anttikes/usb-fm-radio/Schematics/README.md

# The schematic

This folder contains the KiCad schematic and PCB layout file for the board.

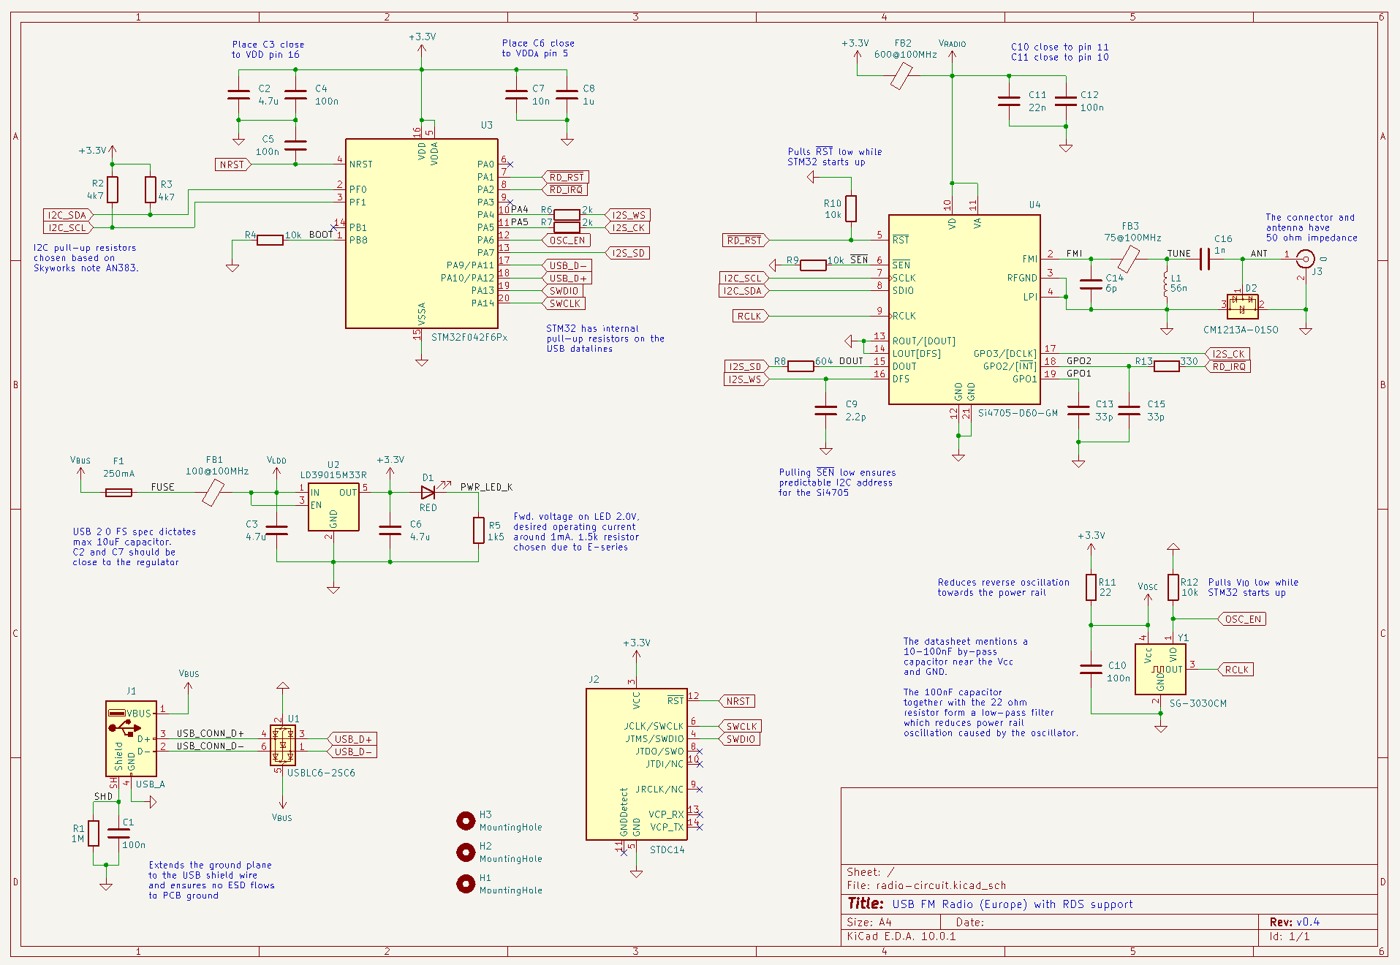
[picture p2: docs/Schematic.png]
Schematic


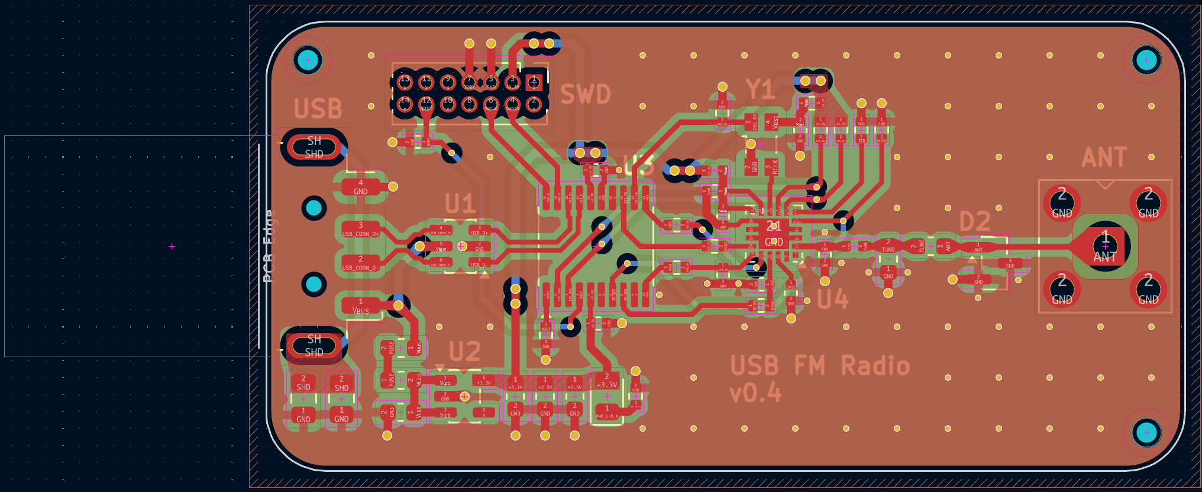
[picture p3: docs/PCBLayout.png]
PCB Layout


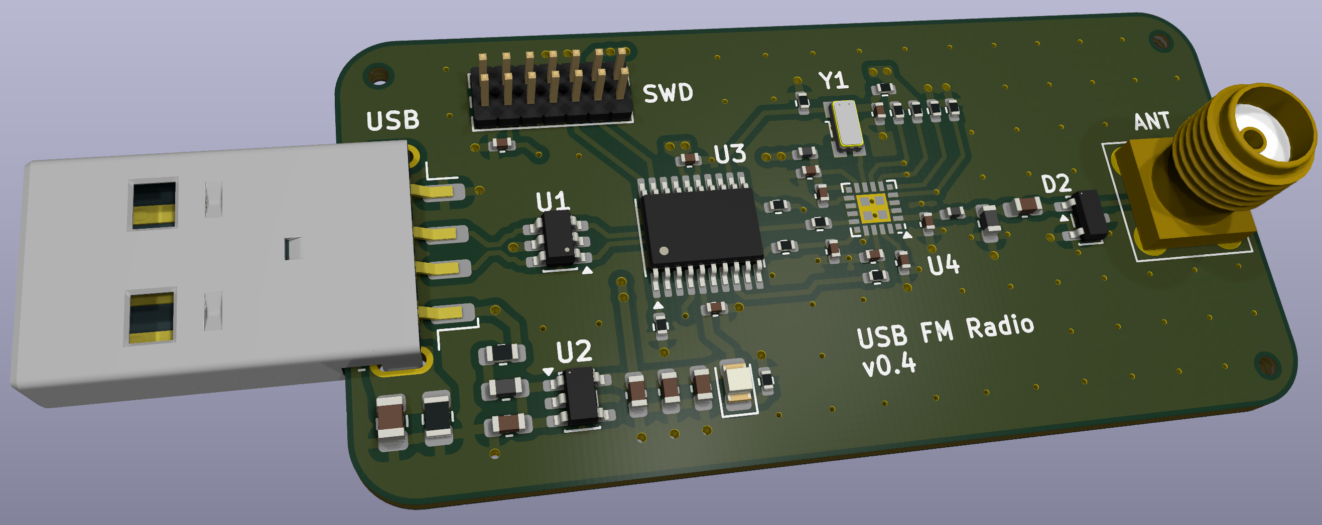
[picture p4: docs/3DModel.png]
3D Model


## Working on the project

To open this project download and install KiCad v10 for your operating system from [this page](https://www.kicad.org/download/).

## Generating the Bill of Materials

The KiCad project file contains a pre-made Bill of Materials definition preset that matches the format expected by JLCPCB. To generate a bill of materials for the project, open the schematic file, first choose "Tools" > "Generate Bill of Materials" and then switch to the "Edit" tab. From the preset selection in bottom-left choose "JLCPCB". Click "Apply, Save Schematic and Continue", and then "Export".

The Bill of Materials file (`radio-circuit.csv`) appears into the `output` folder.

## Generating Gerber, drill and component placement files

The KiCad project file contains the JLCPCB-compatible settings for Gerber and drill files. To generate them open the PCB Editor of the project, and:
 - Choose "File" > "Fabrciation Outputs" > "Gerbers" and "Plot" to generate the `.gbl` files to the `output` folder.
 - Choose "File" > "Fabrication Outputs" > "Drill Files" and "Generate" to generate the `.drl` files to the `output` folder.

Finally, choose "File" > "Fabrication Outputs" > "Component Placement", and click "Generate Position File" to generate the component placement file. The project uses top-side placement only so you can delete the `bottom-pos` file that appears.

### Modifying the component placement file

The file generated is not directly compatible with JLCPCB. You will have to edit the according to [these instructions](https://jlcpcb.com/help/article/How-to-generate-the-BOM-and-Centroid-file-from-KiCAD), from the "Generating Pick and Place files" onwards.
