anttikes/usb-fm-radio/GUI/resources/PowerButton.png

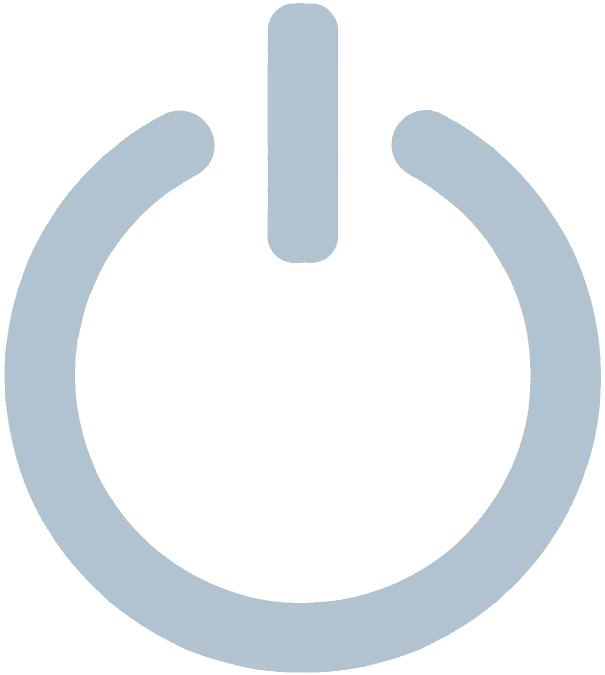
GUI/resources/PowerButton.png
