anttikes/usb-fm-radio/GUI/resources/StereoIndicator.png

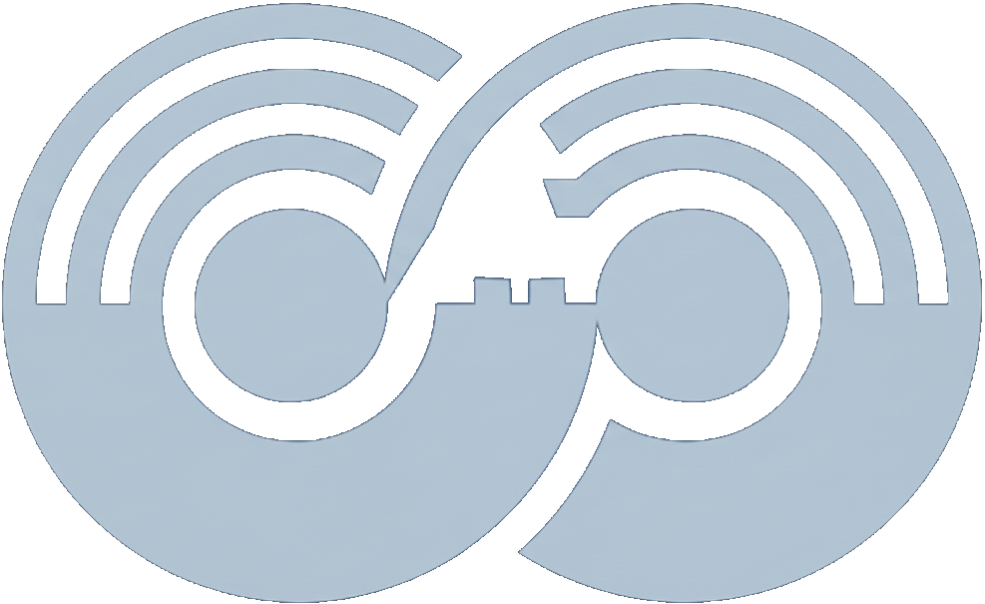
GUI/resources/StereoIndicator.png
