anttikes/usb-fm-radio/Schematics/radio-circuit.kicad_pcb

## KiCad design Schematics/radio-circuit.kicad_pcb (2026-09-28)

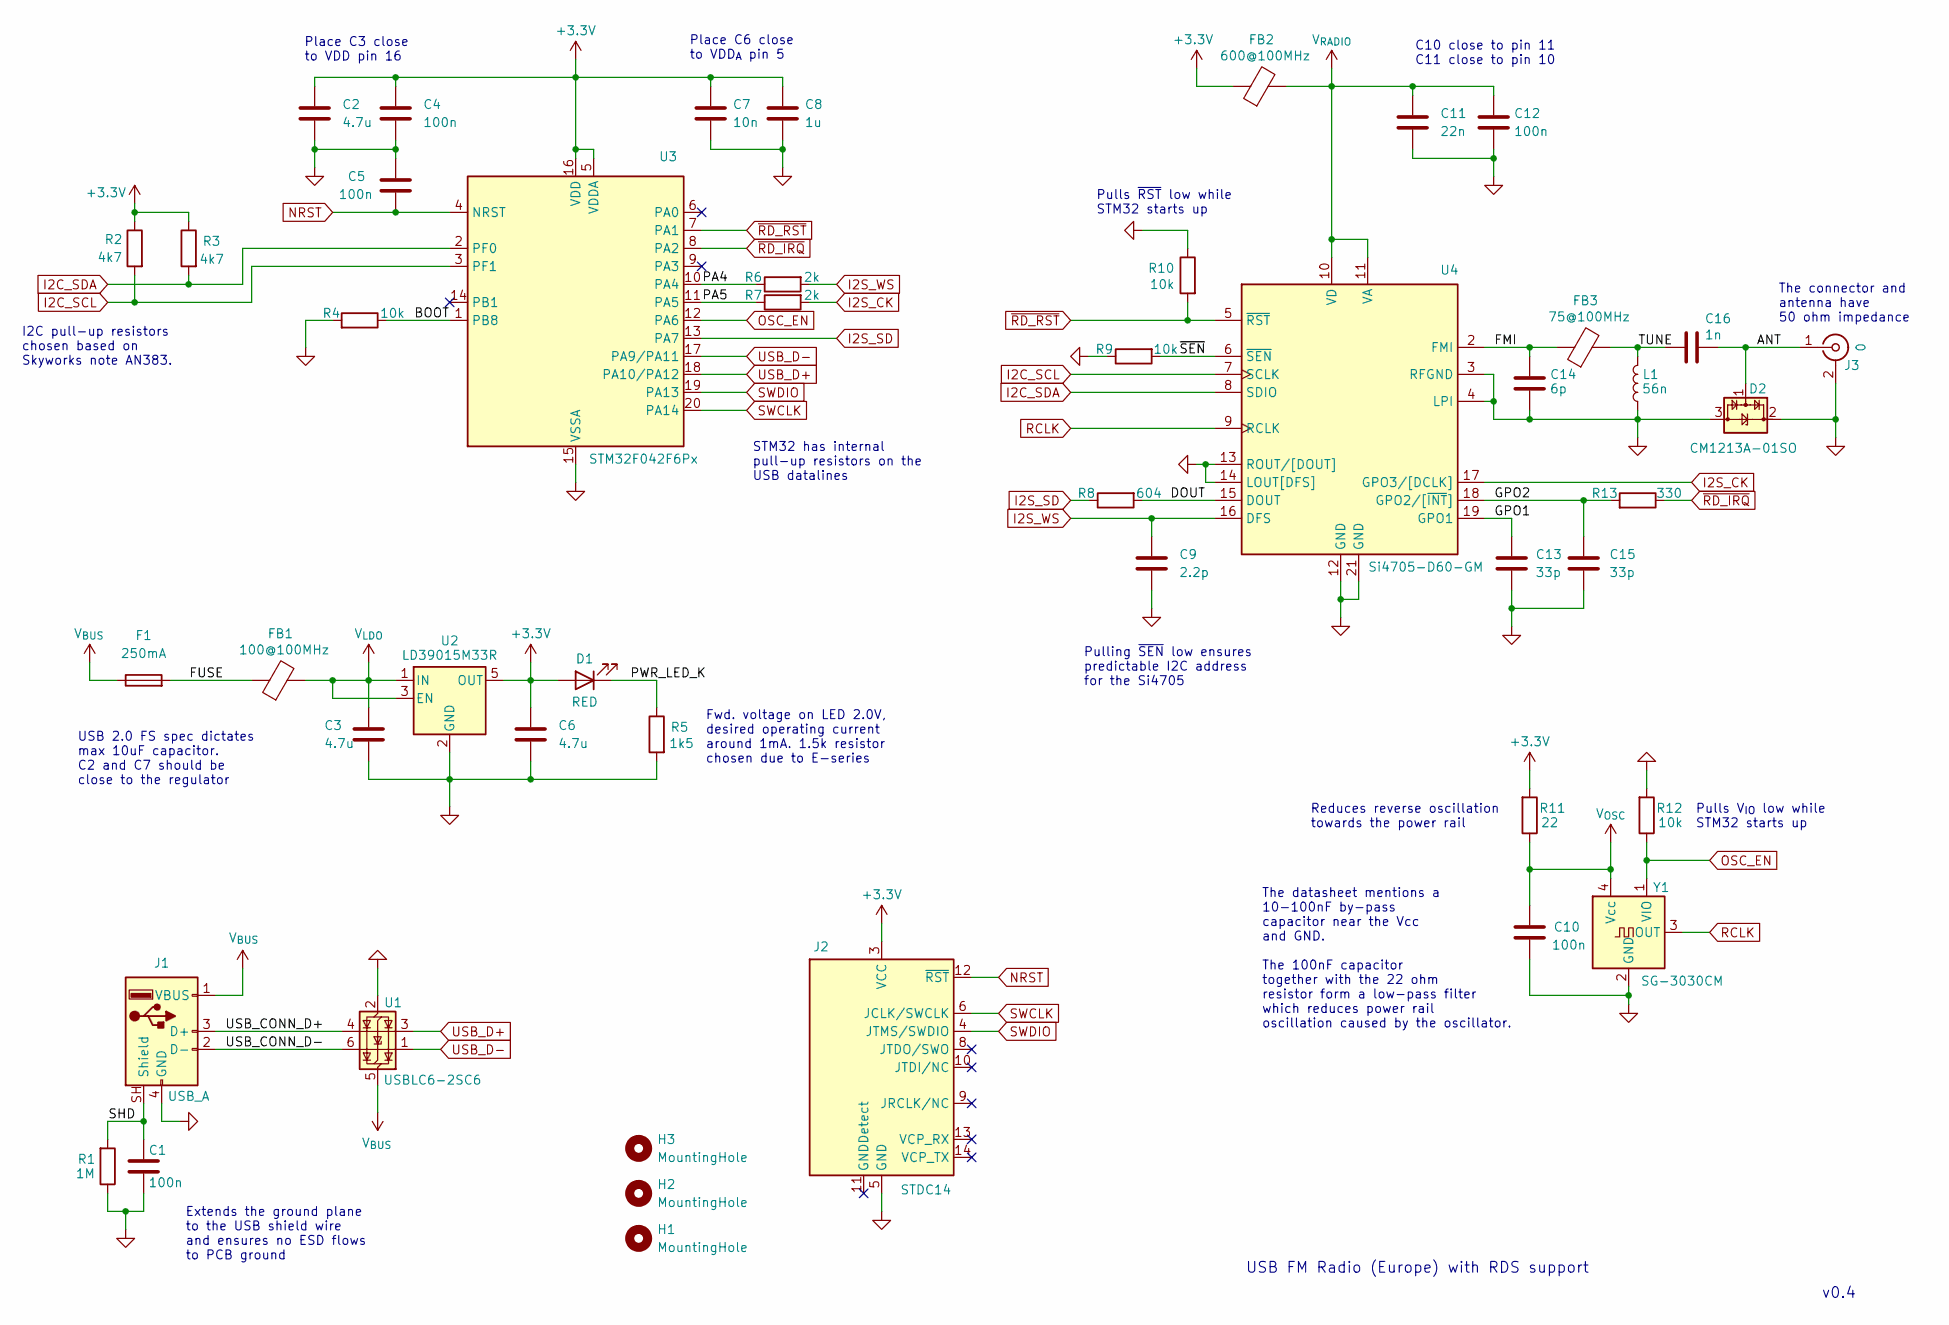
[picture p8: schematic radio-circuit.kicad_sch]

Parts:
C1: 100n; C_0805_2012Metric; JLCPCB Part Number C28233
C2, C3, C6: 4.7u; C_0603_1608Metric; JLCPCB Part Number C19666
C4, C5: 100n; C_0402_1005Metric; JLCPCB Part Number C1525
C7: 10n; C_0402_1005Metric; JLCPCB Part Number C15195
C8: 1u; C_0603_1608Metric; JLCPCB Part Number C15849
C9: 2.2p; C_0402_1005Metric; JLCPCB Part Number C1559
C10, C12: 100n; C_0402_1005Metric; JLCPCB Part Number C307331
C11: 22n; C_0402_1005Metric; JLCPCB Part Number C1532
C13, C15: 33p; C_0402_1005Metric; JLCPCB Part Number C1562
C14: 6p; C_0402_1005Metric; JLCPCB Part Number C30274
C16: 1n; C_0603_1608Metric; JLCPCB Part Number C1636
D1: RED; LED_0805_2012Metric; JLCPCB Part Number C84256
D2: CM1213A-01SO; SOT-23; JLCPCB Part Number C558429
F1: 250mA; Fuse_0603_1608Metric; JLCPCB Part Number C207012
FB1: 100@100MHz; L_0603_1608Metric; JLCPCB Part Number C14709
FB2: 600@100MHz; L_0402_1005Metric; JLCPCB Part Number C76886
FB3: 75@100MHz; L_0402_1005Metric; JLCPCB Part Number C113009
H1, H2, H3: MountingHole; MountingHole_JLCPCB
J1: USB_A; USB_A_AM180-01-T1-W; JLCPCB Part Number C19077262
J2: STDC14; PinHeader_2x07_P1.27mm_Vertical; JLCPCB Part Number C2935955
J3: 0; SMA_BAT_Wireless_BWSMA-KE-Z001; JLCPCB Part Number C496549
L1: 56n; L_0603_1608Metric; JLCPCB Part Number C98080
R1: 1M; R_0805_2012Metric; JLCPCB Part Number C17514
R2, R3: 4k7; R_0402_1005Metric; JLCPCB Part Number C25900
R4, R9, R10, R12: 10k; R_0402_1005Metric; JLCPCB Part Number C25744
R5: 1k5; R_0402_1005Metric; JLCPCB Part Number C25867
R6, R7: 2k; R_0402_1005Metric; JLCPCB Part Number C4109
R8: 604; R_0402_1005Metric; JLCPCB Part Number C8369
R11: 22; R_0402_1005Metric; JLCPCB Part Number C25092
R13: 330; R_0402_1005Metric; JLCPCB Part Number C25104
U1: USBLC6-2SC6; SOT-23-6; JLCPCB Part Number C7519
U2: LD39015M33R; SOT-23-5; JLCPCB Part Number C2798212
U3: STM32F042F6Px; TSSOP-20_4.4x6.5mm_P0.65mm; JLCPCB Part Number C81000
U4: Si4705-D60-GM; Skyworks_QFN-20-1EP_3x3mm_P0.5mm_EP1.8x1.8mm; JLCPCB Part Number C1526114
Y1: SG-3030CM; Oscillator_SMD_SeikoEpson_SG3030CM; JLCPCB Part Number C256005

Connections:
+3.3V: C2.1, C4.1, C6.1, C7.1, C8.1, D1.2 (A), FB2.1, J2.3 (VCC), R2.1, R3.1, R11.2, U2.5 (OUT), U3.5 (VDDA), U3.16 (VDD)
/ ~SEN: R9.2, U4.6 (~SEN)
/ANT: C16.1, D2.1 (CH1), J3.1 (In)
/BOOT: R4.1, U3.1 (PB8)
/DOUT: R8.2, U4.15 (DOUT)
/FMI: C14.1, FB3.1, U4.2 (FMI)
/FUSE: F1.2, FB1.1
/GPO1: C13.1, U4.19 (GPO1)
/GPO2: C15.1, R13.2, U4.18 (GPO2/[~INT])
/PA4: R6.1, U3.10 (PA4)
/PA5: R7.1, U3.11 (PA5)
/PWR_LED_K: D1.1 (K), R5.1
/SHD: C1.2, J1.SH (Shield), R1.2
/TUNE: C16.2, FB3.2, L1.2
/USB_CONN_D+: J1.3 (D+), U1.4 (I/O2)
/USB_CONN_D-: J1.2 (D-), U1.6 (I/O1)
GND: C1.1, C2.2, C3.2, C4.2, C5.2, C6.2, C7.2, C8.2, C9.2, C10.2, C11.2, C12.2, C13.2, C14.2, C15.2, D2.2 (VP), D2.3 (VN), J1.4 (GND), J2.5 (GND), J2.7 (GND), J3.2 (Ext), L1.1, R1.1, R4.2, R5.2, R9.1, R10.1, R12.2, U1.2 (GND), U2.2 (GND), U3.15 (VSSA), U4.3 (RFGND), U4.4 (LPI), U4.12 (GND), U4.13 (ROUT/[DOUT]), U4.14 (LOUT[DFS]), U4.21 (GND), Y1.2 (GND)
I2C_SCL: R2.2, U3.3 (PF1), U4.7 (SCLK)
I2C_SDA: R3.2, U3.2 (PF0), U4.8 (SDIO)
I2S_CK: R7.2, U4.17 (GPO3/[DCLK])
I2S_SD: R8.1, U3.13 (PA7)
I2S_WS: C9.1, R6.2, U4.16 (DFS)
NRST: C5.1, J2.12 (~RST), U3.4 (NRST)
OSC_EN: R12.1, U3.12 (PA6), Y1.1 (VIO)
RCLK: U4.9 (RCLK), Y1.3 (OUT)
SWCLK: J2.6 (JCLK/SWCLK), U3.20 (PA14)
SWDIO: J2.4 (JTMS/SWDIO), U3.19 (PA13)
USB_D+: U1.3 (I/O2), U3.18 (PA10/PA12)
USB_D-: U1.1 (I/O1), U3.17 (PA9/PA11)
V_{BUS}: F1.1, J1.1 (VBUS), U1.5 (VBUS)
V_{LDO}: C3.1, FB1.2, U2.1 (IN), U2.3 (EN)
V_{OSC}: C10.1, R11.1, Y1.4 (Vcc)
V_{RADIO}: C11.1, C12.1, FB2.2, U4.10 (VD), U4.11 (VA)
~RD_IRQ: R13.1, U3.8 (PA2)
~RD_RST: R10.2, U3.7 (PA1), U4.5 (~RST)

Notes on the sheet:
Pulls ~{RST} low while STM32 starts up
Place C6 close to VDD_{A} pin 5
USB FM Radio (Europe) with RDS support
STM32 has internal pull-up resistors on the USB datalines
I2C pull-up resistors chosen based on Skyworks note AN383.
USB 2.0 FS spec dictates max 10uF capacitor. C2 and C7 should be close to the regulator
The connector and antenna have 50 ohm impedance
Extends the ground plane to the USB shield wire and ensures no ESD flows to PCB ground
C10 close to pin 11 C11 close to pin 10
Pulls V_{IO} low while STM32 starts up
Reduces reverse oscillation towards the power rail
v0.4
Pulling ~{SEN} low ensures predictable I2C address for the Si4705
Fwd. voltage on LED 2.0V, desired operating current around 1mA. 1.5k resistor chosen due to E-series
The datasheet mentions a 10-100nF by-pass capacitor near the Vcc and GND. The 100nF capacitor together with the 22 ohm resistor form a low-pass filter which reduces power rail oscillation caused by the oscillator.
Place C3 close to VDD pin 16

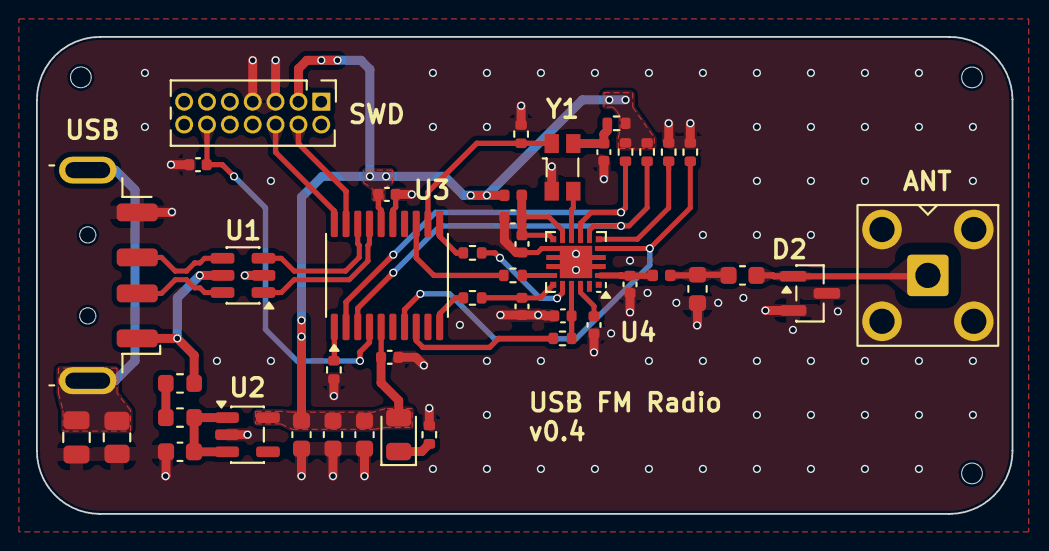
[picture p9: board radio-circuit.kicad_pcb from above]

Board: 4 copper layers, 54.2 x 26.5 mm, 47 parts (0 on the bottom side), 35 nets.
