anttikes/usb-fm-radio/Firmware/Core/main.c

/**
 ******************************************************************************
 * @file    main.c
 * @brief   Main program body
 ******************************************************************************
 * @attention
 *
 * Copyright (c) Antti Keskinen
 * All rights reserved.
 *
 * This software is licensed under terms that can be found in the LICENSE file
 * in the root directory of this software component.
 *
 ******************************************************************************
 */

/* Includes ------------------------------------------------------------------*/
#include "main.h"
#include "commands.h"
#include "common.h"
#include "device.h"
#include "dma.h"
#include "gpio.h"
#include "i2c.h"
#include "i2s.h"
#include "properties.h"
#include "rds.h"
#include "tim.h"
#include "tusb.h"

/* Global variables ----------------------------------------------------------*/

/* Private types -------------------------------------------------------------*/

/* Private constants ---------------------------------------------------------*/

// Size of the staging buffer has an effect on the CPU usage; smaller buffer means
// more interrupts and thus more transfers into the TinyUSB FIFO
// With 2 ms FIFO length, a ratio of 1:4 or smaller causes the
// DMA transfer to occasionally overflow the FIFO buffer
#define DMA_BUFFER_LENGTH CFG_TUD_AUDIO_FUNC_1_EP_IN_SW_BUF_SZ / 8
#define DMA_BUFFER_START 0
#define DMA_BUFFER_MIDPOINT DMA_BUFFER_LENGTH / 2

/* Private macros ------------------------------------------------------------*/

/* Private variables ---------------------------------------------------------*/
uint8_t i2sBuffer[DMA_BUFFER_LENGTH];

/* Private function prototypes -----------------------------------------------*/

/* Exported functions --------------------------------------------------------*/

/**
 * @brief  The application entry point.
 * @retval None
 */
int main(void)
{
    // Initialize HAL
    HAL_Init();

    // Configure the system clock
    SystemClock_Config();

    // Initialize peripherals
    MX_GPIO_Init();
    MX_DMA_Init();
    MX_I2C1_Init();
    MX_I2S1_Init();
    MX_TIM16_Init();
    MX_TIM17_Init();

    // Initialize the RDS parser library
    RDSInit();

    // Bring Si4705 out of reset, and enable the oscillator
    HAL_GPIO_WritePin(RD_RST_GPIO_Port, RD_RST_Pin, GPIO_PIN_SET);
    HAL_GPIO_WritePin(OSC_EN_GPIO_Port, OSC_EN_Pin, GPIO_PIN_SET);

    // The oscillator has a max startup time of one second
    // The radio chip also has a startup time but it is much faster than the
    // crystal
    HAL_Delay(1250);

    // Start the timer that's used to report device status
    HAL_TIM_Base_Start_IT(&htim17);

    // Power up the radio
    if (!PowerUp(&radioDevice,
                 POWER_UP_ARGS_1_FUNCTION_FM | POWER_UP_ARGS_1_GPO2_OUTPUT_ENABLE |
                     POWER_UP_ARGS_1_CTS_INTERRUPT_ENABLE,
                 POWER_UP_ARGS_2_DIGITAL_OUTPUT_2))
    {
        Error_Handler();
    }

    // Enable other interrupt sources
    if (!SetInterruptSources(&radioDevice,
                             GPO_IEN_ARGS_CTSIEN | GPO_IEN_ARGS_STCIEN | GPO_IEN_ARGS_RDSIEN | GPO_IEN_ARGS_ERRIEN))
    {
        Error_Handler();
    }

    // Initialize volume from the radio state
    if (!SetVolume(&radioDevice, radioDevice.currentVolume))
    {
        Error_Handler();
    }

    // Allow GPO output, and drive GPO1 and GPO3 low to reduce oscillation
    if (!GPIOCtl(&radioDevice, GPIO_CTL_GPO1_OUTPUT_ENABLE | GPIO_CTL_GPO3_OUTPUT_ENABLE))
    {
        Error_Handler();
    }

    if (!GPIOSet(&radioDevice, GPIO_SET_GPO2_OUTPUT_HIGH))
    {
        Error_Handler();
    }

    // Set FM de-emphasis to match Europe
    if (!SetFMDeemphasis(&radioDevice, FM_DEEMPHASIS_ARGS_50_MICROSECONDS))
    {
        Error_Handler();
    }

    // Configure RDS to raise interrupt when buffers are full
    if (!SetRDSInterruptSources(&radioDevice, FM_RDS_INT_SOURCE_ARGS_RDSRECV))
    {
        Error_Handler();
    }

    // Enable RDS processing, and allow max number of errors
    if (!SetRDSConfig(&radioDevice, FM_RDS_CONFIG_ARGS_BLETHA_ERROR_MAX_5_BITS |
                                        FM_RDS_CONFIG_ARGS_BLETHB_ERROR_MAX_5_BITS |
                                        FM_RDS_CONFIG_ARGS_BLETHC_ERROR_MAX_5_BITS |
                                        FM_RDS_CONFIG_ARGS_BLETHD_ERROR_MAX_5_BITS | FM_RDS_CONFIG_ARGS_RDS_ENABLE))
    {
        Error_Handler();
    }

    // Tune to Kasari
    if (!TuneFreq(&radioDevice, FM_TUNE_FREQ_ARGS_NONE, 9410))
    {
        Error_Handler();
    }

    // Start receiving I2S data through DMA; this provides DCLK and DFS
    // for the radio chip. When using circular mode, the size parameter
    // must equal the number of audio samples we want to read during one cycle
    if (HAL_I2S_Receive_DMA(&hi2s1, (uint16_t *)&i2sBuffer[0], DMA_BUFFER_LENGTH / 2) != HAL_OK)
    {
        Error_Handler();
    }

    // USB needs only peripheral clock and interrupt priority; TinyUSB takes care of the rest
    __HAL_RCC_USB_CLK_ENABLE();
    HAL_NVIC_SetPriority(USB_IRQn, 0, 0);

    // Initialize TinyUSB
    tusb_rhport_init_t dev_init = {.role = TUSB_ROLE_DEVICE, .speed = TUSB_SPEED_FULL};

    tusb_init(BOARD_DEVICE_RHPORT_NUM, &dev_init);

    /* Infinite loop */
    while (1)
    {
        tud_task();

        if (!ProcessCommand(&radioDevice))
        {
            if (radioDevice.interruptCounter > 0)
            {
                radioDevice.interruptCounter--;

                // There was no command to process but an interrupt is pending
                // This usually indicates e.g. RDS or RSQ interrupt
                // so schedule the GetIntStatus command
                GetIntStatus(&radioDevice);
            }
        }

        ProcessReport(&radioDevice);
    }
}

/**
 * @brief System Clock Configuration
 * @retval None
 */
void SystemClock_Config(void)
{
    RCC_OscInitTypeDef RCC_OscInitStruct = {0};
    RCC_ClkInitTypeDef RCC_ClkInitStruct = {0};
    RCC_PeriphCLKInitTypeDef PeriphClkInit = {0};
    RCC_CRSInitTypeDef RCC_CRSInitStruct = {0};

    /* Initialize the RCC Oscillators */
    RCC_OscInitStruct.OscillatorType = RCC_OSCILLATORTYPE_HSI48;
    RCC_OscInitStruct.HSI48State = RCC_HSI48_ON;
    RCC_OscInitStruct.PLL.PLLState = RCC_PLL_ON;
    RCC_OscInitStruct.PLL.PLLSource = RCC_PLLSOURCE_HSI48;
    RCC_OscInitStruct.PLL.PLLMUL = RCC_PLL_MUL4;
    RCC_OscInitStruct.PLL.PREDIV = RCC_PREDIV_DIV5;

    if (HAL_RCC_OscConfig(&RCC_OscInitStruct) != HAL_OK)
    {
        Error_Handler();
    }

    /* Initialize the CPU, AHB and APB buses clocks */
    RCC_ClkInitStruct.ClockType = RCC_CLOCKTYPE_HCLK | RCC_CLOCKTYPE_SYSCLK | RCC_CLOCKTYPE_PCLK1;
    RCC_ClkInitStruct.SYSCLKSource = RCC_SYSCLKSOURCE_PLLCLK;
    RCC_ClkInitStruct.AHBCLKDivider = RCC_SYSCLK_DIV1;
    RCC_ClkInitStruct.APB1CLKDivider = RCC_HCLK_DIV1;

    if (HAL_RCC_ClockConfig(&RCC_ClkInitStruct, FLASH_LATENCY_1) != HAL_OK)
    {
        Error_Handler();
    }

    PeriphClkInit.PeriphClockSelection = RCC_PERIPHCLK_USB | RCC_PERIPHCLK_I2C1;
    PeriphClkInit.I2c1ClockSelection = RCC_I2C1CLKSOURCE_SYSCLK;
    PeriphClkInit.UsbClockSelection = RCC_USBCLKSOURCE_HSI48;

    if (HAL_RCCEx_PeriphCLKConfig(&PeriphClkInit) != HAL_OK)
    {
        Error_Handler();
    }

    /* Enable the CRS clock */
    __HAL_RCC_CRS_CLK_ENABLE();

    /* Configure CRS */
    RCC_CRSInitStruct.Prescaler = RCC_CRS_SYNC_DIV1;
    RCC_CRSInitStruct.Source = RCC_CRS_SYNC_SOURCE_USB;
    RCC_CRSInitStruct.Polarity = RCC_CRS_SYNC_POLARITY_RISING;
    RCC_CRSInitStruct.ReloadValue = __HAL_RCC_CRS_RELOADVALUE_CALCULATE(48000000, 1000);
    RCC_CRSInitStruct.ErrorLimitValue = 34;
    RCC_CRSInitStruct.HSI48CalibrationValue = 32;

    HAL_RCCEx_CRSConfig(&RCC_CRSInitStruct);
}

/**
 * @brief  This function is executed in case of error occurrence.
 * @retval None
 */
void Error_Handler(void)
{
    /* User can add his own implementation to report the HAL error return state */
    __disable_irq();
    while (1)
    {
    }
}

/* External callbacks --------------------------------------------------------*/

/**
 * @brief  Rx Transfer half completed callbacks
 * @param  hi2s pointer to a I2S_HandleTypeDef structure that contains
 *         the configuration information for I2S module
 * @retval None
 */
void HAL_I2S_RxHalfCpltCallback(I2S_HandleTypeDef *hi2s)
{
    if (hi2s->Instance == SPI1)
    {
        tud_audio_write(&i2sBuffer[DMA_BUFFER_START], DMA_BUFFER_LENGTH / 2);
    }
}

/**
 * @brief  Rx Transfer completed callbacks
 * @param  hi2s pointer to a I2S_HandleTypeDef structure that contains
 *         the configuration information for I2S module
 * @retval None
 */
void HAL_I2S_RxCpltCallback(I2S_HandleTypeDef *hi2s)
{
    if (hi2s->Instance == SPI1)
    {
        tud_audio_write(&i2sBuffer[DMA_BUFFER_MIDPOINT], DMA_BUFFER_LENGTH / 2);
    }
}

/* Private functions ---------------------------------------------------------*/

#ifdef USE_FULL_ASSERT
/**
 * @brief  Reports the name of the source file and the source line number
 *         where the assert_param error has occurred.
 * @param  file: pointer to the source file name
 * @param  line: assert_param error line source number
 * @retval None
 */
void assert_failed(uint8_t *file, uint32_t line)
{
    UNUSED(file);
    UNUSED(line);

    /* User can add his own implementation to report the file name and line
       number, ex: printf("Wrong parameters value: file %s on line %d\r\n", file,
       line) */
}
#endif /* USE_FULL_ASSERT */
