anttikes/usb-fm-radio/Firmware/Firmware.ioc

Mcu.UserName=STM32F042C6Tx
PA11.Signal=USB_DM
PA12.Signal=USB_DP
PA13.Signal=SYS_SWDIO
PA14.Signal=SYS_SWCLK
PA4.Signal=I2S1_WS
PA5.Signal=I2S1_CK
PA7.Signal=I2S1_SD
PC13.GPIO_Label=RADIO_NIRQ
PC13.Signal=GPXTI13
PC14OSC32_IN.GPIO_Label=RADIO_NRST
PC14OSC32_IN.Signal=GPIO_Output
PC15OSC32_OUT.GPIO_Label=RCLK_EN
PC15OSC32_OUT.Signal=GPIO_Output
PF0-OSC_IN.Signal=I2C1_SDA
PF1-OSC_OUT.Signal=I2C1_SCL
