anttikes/usb-fm-radio/Firmware/Radio/device.c

/**
 ******************************************************************************
 * @file    device.h
 * @brief   Implements functions to manage radio device state and
 *          command processing.
 ******************************************************************************
 * @attention
 *
 * Copyright (c) Antti Keskinen
 * All rights reserved.
 *
 * This software is licensed under terms that can be found in the LICENSE file
 * in the root directory of this software component.
 *
 ******************************************************************************
 */

/* Includes ------------------------------------------------------------------*/
#include "device.h"
#include "commands.h"
#include "common.h"
#include "i2c.h"
#include "main.h"
#include "rds.h"
#include "stm32f0xx_hal.h"
#include "tim.h"
#include "tusb.h"

/* Global variables ----------------------------------------------------------*/

// clang-format off
RadioDevice_t radioDevice = {
    .deviceAddress = SI4705_I2C_ADDRESS,
    .currentState = RADIOSTATE_POWERDOWN,
    .currentFrequency = 0,
    .currentVolume = SI4705_VOLUME_MAX_SETTING / 2,
    .interruptCounter = 0,
    .isMuted = false,
    .commandQueue = {
        .commands = {{0}},
        .count = 0,
        .front = 0,
        .back = 0
    },
    .reportQueue = {
        .reports = {{0}},
        .count = 0,
        .front = 0,
        .back = 0
    }
};
// clang-format on

/* Private types -------------------------------------------------------------*/

/* Private constants ---------------------------------------------------------*/

/* Private macros ------------------------------------------------------------*/

/* Private variables ---------------------------------------------------------*/
volatile bool i2cTransferInterruptRaised = false;
volatile bool i2cReceiveInterruptRaised = false;

/* Private function prototypes -----------------------------------------------*/
static Command_t *PeekCommand(CommandQueue_t *queue);
static Command_t *PopCommand(CommandQueue_t *queue);
static Report_t *PopReport(ReportQueue_t *queue);

/* Exported functions --------------------------------------------------------*/

/**
 * @brief  Processes the commands in the queue, if there are any
 * @param  device Pointer to the radio device structure
 *
 * @retval True if a command was somehow processed; false otherwise
 */
bool ProcessCommand(RadioDevice_t *device)
{
    volatile Command_t *currentCommand = PeekCommand(&device->commandQueue);

    if (currentCommand == NULL)
    {
        return false;
    }

    if (currentCommand->state == COMMANDSTATE_IDLE)
    {
        currentCommand->state = COMMANDSTATE_SENDING;

        HAL_StatusTypeDef status = HAL_I2C_Master_Transmit_IT(
            &hi2c1, device->deviceAddress, (uint8_t *)&currentCommand->args, currentCommand->argLength);

        if (status != HAL_OK)
        {
            Error_Handler();
        }

        return true;
    }
    else if (currentCommand->state == COMMANDSTATE_SENDING && i2cTransferInterruptRaised)
    {
        i2cTransferInterruptRaised = false;

        if (currentCommand->args.opCode == CMD_ID_FM_TUNE_FREQ || currentCommand->args.opCode == CMD_ID_FM_SEEK_START)
        {
            radioDevice.currentState = RADIOSTATE_TUNE_IN_PROGRESS;

            currentCommand->state = COMMANDSTATE_WAITING_FOR_STC;
        }
        else
        {
            currentCommand->state = COMMANDSTATE_WAITING_FOR_CTS;
        }

        return true;
    }
    else if (currentCommand->state == COMMANDSTATE_WAITING_FOR_STC && radioDevice.interruptCounter > 0)
    {
        radioDevice.interruptCounter--;

        currentCommand->state = COMMANDSTATE_WAITING_FOR_CTS;

        return true;
    }
    else if (currentCommand->state == COMMANDSTATE_WAITING_FOR_CTS && radioDevice.interruptCounter > 0)
    {
        radioDevice.interruptCounter--;

        if (currentCommand->responseLength > 0)
        {
            currentCommand->state = COMMANDSTATE_WAITING_FOR_RESPONSE_RETRIEVAL;
        }
        else
        {
            currentCommand->state = COMMANDSTATE_READY;
        }

        return true;
    }
    else if (currentCommand->state == COMMANDSTATE_WAITING_FOR_RESPONSE_RETRIEVAL)
    {
        currentCommand->state = COMMANDSTATE_RECEIVING_RESPONSE;

        HAL_StatusTypeDef status = HAL_I2C_Master_Receive_IT(
            &hi2c1, device->deviceAddress, (uint8_t *)&currentCommand->response, currentCommand->responseLength);

        if (status != HAL_OK)
        {
            Error_Handler();
        }

        return true;
    }
    else if (currentCommand->state == COMMANDSTATE_RECEIVING_RESPONSE && i2cReceiveInterruptRaised)
    {
        i2cReceiveInterruptRaised = false;

        currentCommand->state = COMMANDSTATE_RESPONSE_RECEIVED;

        return true;
    }
    else if (currentCommand->state == COMMANDSTATE_RESPONSE_RECEIVED)
    {
        switch (currentCommand->args.opCode)
        {
        case CMD_ID_GET_PROPERTY:
            ProcessGetProperty(device, (Command_t *)currentCommand);
            break;

        case CMD_ID_FM_RSQ_STATUS:
            ProcessRSQStatus(device, (Command_t *)currentCommand);
            break;

        default:
            break;
        }

        currentCommand->state = COMMANDSTATE_READY;
    }
    else if (currentCommand->state == COMMANDSTATE_READY)
    {
        if (currentCommand->args.opCode == CMD_ID_POWER_UP && currentCommand->responseLength == 0)
        {
            device->currentState = RADIOSTATE_POWERUP;
        }
        else if (currentCommand->args.opCode == CMD_ID_POWER_DOWN)
        {
            device->currentState = RADIOSTATE_POWERDOWN;

            HAL_TIM_Base_Stop(&htim16);
        }
        else if (currentCommand->args.opCode == CMD_ID_FM_TUNE_FREQ ||
                 currentCommand->args.opCode == CMD_ID_FM_SEEK_START)
        {
            device->currentState = RADIOSTATE_TUNED_TO_STATION;

            HAL_TIM_Base_Start_IT(&htim16);

            // After tuning or seek has completed, set the sample rate so the chip begins sending audio samples
            SetProperty(&radioDevice, PROP_ID_DIGITAL_OUTPUT_SAMPLE_RATE, CFG_TUD_AUDIO_FUNC_1_SAMPLE_RATE);

            // Schedule a GetTuneStatus to update the current frequency reading and clear the STCINT bit
            TuneStatus(device, GET_TUNE_STATUS_ARGS_INTACK);

            // Reset the RDS parser state
            RDSReset();
        }
        else if (currentCommand->args.opCode == CMD_ID_FM_TUNE_STATUS)
        {
            device->currentFrequency =
                (uint16_t)((currentCommand->response[2] << 8) | (currentCommand->response[3] << 0));
        }
        else if (currentCommand->args.opCode == CMD_ID_GET_INT_STATUS)
        {
            // bool clearToSend = currentCommand->response[0] & 0x80;
            // bool error = currentCommand->response[0] & 0x40;
            // bool rsqInterrupt = currentCommand->response[0] & 0x08;
            bool rdsInterrupt = currentCommand->response[0] & 0x04;
            // bool seekTuneCompleted = currentCommand->response[0] & 0x01;

            if (rdsInterrupt)
            {
                RDSStatus(device, FM_RDS_STATUS_ARGS_INTACK);
            }
        }
        else if (currentCommand->args.opCode == CMD_ID_SET_PROPERTY)
        {
            PropertyIdentifiers_t property =
                (PropertyIdentifiers_t)((currentCommand->args.bytes[2] << 8) | (currentCommand->args.bytes[3] << 0));

            uint16_t value = (uint16_t)((currentCommand->args.bytes[4] << 8) | (currentCommand->args.bytes[5] << 0));

            if (property == PROP_ID_DIGITAL_OUTPUT_SAMPLE_RATE)
            {
                if (value != 0)
                {
                    device->currentState = RADIOSTATE_DIGITAL_OUTPUT_ENABLED;
                }
                else
                {
                    device->currentState = RADIOSTATE_TUNED_TO_STATION;
                }
            }
            else if (property == PROP_ID_RX_VOLUME)
            {
                device->currentVolume = value;
            }
            else if (property == PROP_ID_RX_HARD_MUTE)
            {
                if (value == 0)
                {
                    device->isMuted = false;
                }
                else if (value & 0b11)
                {
                    device->isMuted = true;
                }

                // Per-channel mute status is not supported
            }

            // Tuner programming guide outlines that a property
            // set operation always completes in 10 ms
            HAL_Delay(10);
        }
        else if (currentCommand->args.opCode == CMD_ID_FM_RDS_STATUS)
        {
            uint8_t fifoCount = currentCommand->response[3];

            uint16_t blockA = (uint16_t)((currentCommand->response[4] << 8) | (currentCommand->response[5] << 0));
            uint16_t blockB = (uint16_t)((currentCommand->response[6] << 8) | (currentCommand->response[7] << 0));
            uint16_t blockC = (uint16_t)((currentCommand->response[8] << 8) | (currentCommand->response[9] << 0));
            uint16_t blockD = (uint16_t)((currentCommand->response[10] << 8) | (currentCommand->response[11] << 0));

            uint8_t blockAErrors = currentCommand->response[12] & 0xC0;
            uint8_t blockBErrors = currentCommand->response[12] & 0x30;
            uint8_t blockCErrors = currentCommand->response[12] & 0x0C;
            uint8_t blockDErrors = currentCommand->response[12] & 0x03;

            ProcessRDSData(blockA, blockB, blockC, blockD, blockAErrors, blockBErrors, blockCErrors, blockDErrors);

            if (fifoCount > 0)
            {
                // Schedule a new retrieval until the FIFO is empty
                RDSStatus(device, FM_RDS_STATUS_ARGS_NONE);
            }
        }

        PopCommand(&device->commandQueue);
    }

    // Current command is executing; nothing to do at this time
    return true;
}

/**
 * @brief  Processes the next report from the queue, if there are any
 * @param  device Pointer to the radio device structure
 *
 * @retval True if a report was processed; false otherwise
 */
bool ProcessReport(RadioDevice_t *device)
{
    Report_t *currentReport = PopReport(&device->reportQueue);

    if (currentReport == NULL)
    {
        return false;
    }

    return tud_hid_report(currentReport->identifier, currentReport->bytes.raw, MAX_STRUCT_SIZE);
}

/**
 * @brief  Enqueues the give command into the command queue of the radio device
 * @param  device Pointer to the radio device structure
 * @param  command Pointer to the command
 *
 * @retval True if the command was enqueued; false otherwise
 */
bool EnqueueCommand(RadioDevice_t *device, Command_t *command)
{
    if (device == NULL || command == NULL)
    {
        return false;
    }

    volatile CommandQueue_t *queue = &device->commandQueue;

    if (queue->count >= MAX_COMMAND_QUEUE_CAPACITY)
    {
        /* Queue full */
        return false;
    }

    queue->commands[queue->back] = *command;
    queue->back = (uint8_t)((queue->back + 1) % MAX_COMMAND_QUEUE_CAPACITY);
    queue->count++;

    return true;
}

/**
 * @brief  Enqueues the given report into the queue
 * @param  device Pointer to the radio device structure
 * @param  command Pointer to the report
 *
 * @retval True if the report was enqueued; false otherwise
 */
bool EnqueueReport(RadioDevice_t *device, Report_t *report)
{
    if (device == NULL || report == NULL)
    {
        return false;
    }

    volatile ReportQueue_t *queue = &device->reportQueue;

    if (queue->count >= MAX_REPORT_QUEUE_CAPACITY)
    {
        /* Queue full */
        return false;
    }

    queue->reports[queue->back] = *report;
    queue->back = (uint8_t)((queue->back + 1) % MAX_REPORT_QUEUE_CAPACITY);
    queue->count++;

    return true;
}

/* External callbacks --------------------------------------------------------*/

/**
 * @brief  Invoked by HAL when a EXTI interrupt has occurred.
 * @param  GPIO_Pin Specifies the port pin connected to corresponding EXTI line.
 * @retval None
 */
void HAL_GPIO_EXTI_Callback(uint16_t GPIO_Pin)
{
    if (GPIO_Pin == RD_IRQ_Pin)
    {
        radioDevice.interruptCounter++;
    }
}

/**
 * @brief  Invoked by HAL when I2C Master transmit has completed.
 * @param  hi2c Pointer to a I2C_HandleTypeDef structure that contains
 *              the configuration information for the specified I2C.
 * @retval None
 */
void HAL_I2C_MasterTxCpltCallback(I2C_HandleTypeDef *hi2c)
{
    if (hi2c->Instance == hi2c1.Instance)
    {
        i2cTransferInterruptRaised = true;
    }
}

/**
 * @brief  Invoked by HAL when I2C Master receive has completed.
 * @param  hi2c Pointer to a I2C_HandleTypeDef structure that contains
 *              the configuration information for the specified I2C.
 * @retval None
 */
void HAL_I2C_MasterRxCpltCallback(I2C_HandleTypeDef *hi2c)
{
    if (hi2c->Instance == hi2c1.Instance)
    {
        i2cReceiveInterruptRaised = true;
    }
}

/**
 * @brief  Invoked by HAL when an I2C transaction encounters an error.
 * @param  hi2c Pointer to a I2C_HandleTypeDef structure that contains
 *              the configuration information for the specified I2C.
 * @retval None
 */
void HAL_I2C_ErrorCallback(I2C_HandleTypeDef *hi2c)
{
    /* Prevent unused argument(s) compilation warning */
    UNUSED(hi2c);
}

#ifdef DEBUG

extern uint32_t _sstack;
extern uint32_t _estack;
extern const uint32_t stack_watermark_pattern;

#endif /* DEBUG */

/**
 * @brief  Period elapsed callback in non-blocking mode
 * @param  htim TIM handle
 * @retval None
 */
void HAL_TIM_PeriodElapsedCallback(TIM_HandleTypeDef *htim)
{
    if (htim->Instance == TIM16)
    {
        // Timer 16 is used to periodically query RSQ status when tuned to a station
        if (radioDevice.currentState >= RADIOSTATE_TUNED_TO_STATION)
        {
            RSQStatus(&radioDevice, FM_RSQ_STATUS_ARGS_NONE);
        }
    }
    else if (htim->Instance == TIM17)
    {
        // Timer 17 is used to periodically report device state
        Report_t report = {0};

        report.identifier = REPORT_IDENTIFIER_DEVICE_STATUS;

        report.bytes.deviceStatus.currentState = radioDevice.currentState;
        report.bytes.deviceStatus.currentFrequency = radioDevice.currentFrequency;
        report.bytes.deviceStatus.currentVolume = radioDevice.currentVolume;
        report.bytes.deviceStatus.commandQueueCount = radioDevice.commandQueue.count;
        report.bytes.deviceStatus.reportQueueCount = radioDevice.reportQueue.count;
        report.bytes.deviceStatus.isMuted = radioDevice.isMuted;

#ifdef DEBUG
        const uint32_t *ptr = &_sstack;
        const uint32_t *const end = &_estack;

        while (ptr < end)
        {
            if (*ptr != stack_watermark_pattern)
            {
                size_t unusedWords = (size_t)(end - ptr);
                report.bytes.deviceStatus.stackUsage = (uint32_t)(unusedWords * sizeof(uint32_t));
                break;
            }

            ptr++;
        }
#endif /* DEBUG */

        EnqueueReport(&radioDevice, &report);
    }
}

/* Private functions ---------------------------------------------------------*/

/**
 * @brief  Peeks the first command from the queue without removing it
 * @param  queue Pointer to the queue
 *
 * @retval Pointer to the first command in the queue or NULL if the queue is empty
 */
static Command_t *PeekCommand(CommandQueue_t *queue)
{
    if (queue == NULL || queue->count == 0)
    {
        return NULL;
    }

    return &queue->commands[queue->front];
}

/**
 * @brief  Pops the first command from the queue, removing it
 * @param  queue Pointer to the queue
 *
 * @retval Pointer to the first command in the queue or NULL if the queue is empty
 */
static Command_t *PopCommand(CommandQueue_t *queue)
{
    if (queue == NULL || queue->count == 0)
    {
        return NULL;
    }

    Command_t *command = &queue->commands[queue->front];
    const uint8_t capacity = (uint8_t)(sizeof(queue->commands) / sizeof(queue->commands[0]));
    queue->front = (uint8_t)((queue->front + 1) % capacity);
    queue->count--;

    return command;
}

/**
 * @brief  Pops the first report from the queue, removing it
 * @param  queue Pointer to the queue
 *
 * @retval Pointer to the first report in the queue or NULL if the queue is empty
 */
static Report_t *PopReport(ReportQueue_t *queue)
{
    if (queue == NULL || queue->count == 0)
    {
        return NULL;
    }

    Report_t *report = &queue->reports[queue->front];
    const uint8_t capacity = (uint8_t)(sizeof(queue->reports) / sizeof(queue->reports[0]));
    queue->front = (uint8_t)((queue->front + 1) % capacity);
    queue->count--;

    return report;
}
