anttikes/usb-fm-radio/Firmware/Core/i2c.c

/**
 ******************************************************************************
 * @file    i2c.c
 * @brief   This file provides code for the configuration
 *          of the I2C instances.
 ******************************************************************************
 * @attention
 *
 * Copyright (c) Antti Keskinen
 * All rights reserved.
 *
 * This software is licensed under terms that can be found in the LICENSE file
 * in the root directory of this software component.
 *
 ******************************************************************************
 */

/* Includes ------------------------------------------------------------------*/
#include "i2c.h"

/* Global variables ----------------------------------------------------------*/
I2C_HandleTypeDef hi2c1;

/* Private types -------------------------------------------------------------*/

/* Private constants ---------------------------------------------------------*/

/* Private macros ------------------------------------------------------------*/

/* Private variables ---------------------------------------------------------*/

/* Private function prototypes -----------------------------------------------*/

/* Exported functions --------------------------------------------------------*/

/**
 * @brief  Initialize I2C1
 * @retval None
 */
void MX_I2C1_Init(void)
{
    hi2c1.Instance = I2C1;
    hi2c1.Init.Timing = 0x0070133B;
    hi2c1.Init.OwnAddress1 = 0;
    hi2c1.Init.AddressingMode = I2C_ADDRESSINGMODE_7BIT;
    hi2c1.Init.DualAddressMode = I2C_DUALADDRESS_DISABLE;
    hi2c1.Init.OwnAddress2 = 0;
    hi2c1.Init.OwnAddress2Masks = I2C_OA2_NOMASK;
    hi2c1.Init.GeneralCallMode = I2C_GENERALCALL_DISABLE;
    hi2c1.Init.NoStretchMode = I2C_NOSTRETCH_DISABLE;

    if (HAL_I2C_Init(&hi2c1) != HAL_OK)
    {
        Error_Handler();
    }

    /* Configure Analogue filter */
    if (HAL_I2CEx_ConfigAnalogFilter(&hi2c1, I2C_ANALOGFILTER_ENABLE) != HAL_OK)
    {
        Error_Handler();
    }

    /* Configure Digital filter */
    if (HAL_I2CEx_ConfigDigitalFilter(&hi2c1, 0) != HAL_OK)
    {
        Error_Handler();
    }
}

/* External callbacks --------------------------------------------------------*/

/**
 * @brief  Invoked by HAL to perform lower level initialization
 * @param  hi2c Pointer to a I2C_HandleTypeDef structure that contains
 *              the configuration information for the specified I2C.
 * @retval None
 */
void HAL_I2C_MspInit(I2C_HandleTypeDef *hi2c)
{
    GPIO_InitTypeDef GPIO_InitStruct = {0};

    if (hi2c->Instance == I2C1)
    {
        __HAL_RCC_GPIOF_CLK_ENABLE();

        /* I2C1 GPIO Configuration
        PF0-OSC_IN     ------> I2C1_SDA
        PF1-OSC_OUT    ------> I2C1_SCL
        */
        GPIO_InitStruct.Pin = GPIO_PIN_0 | GPIO_PIN_1;
        GPIO_InitStruct.Mode = GPIO_MODE_AF_OD;
        GPIO_InitStruct.Pull = GPIO_NOPULL;
        GPIO_InitStruct.Speed = GPIO_SPEED_FREQ_HIGH;
        GPIO_InitStruct.Alternate = GPIO_AF1_I2C1;
        HAL_GPIO_Init(GPIOF, &GPIO_InitStruct);

        /* I2C1 clock enable */
        __HAL_RCC_I2C1_CLK_ENABLE();

        /* I2C1 interrupt Init */
        HAL_NVIC_SetPriority(I2C1_IRQn, 0, 0);
        HAL_NVIC_EnableIRQ(I2C1_IRQn);
    }
}

/**
 * @brief  Invoked by HAL to perform lower level de-initialization
 * @param  hi2c Pointer to a I2C_HandleTypeDef structure that contains
 *              the configuration information for the specified I2C.
 * @retval None
 */
void HAL_I2C_MspDeInit(I2C_HandleTypeDef *hi2c)
{
    if (hi2c->Instance == I2C1)
    {
        /* Peripheral clock disable */
        __HAL_RCC_I2C1_CLK_DISABLE();

        /* I2C1 GPIO Configuration
        PF0-OSC_IN     <------ I2C1_SDA
        PF1-OSC_OUT    <------ I2C1_SCL
        */
        HAL_GPIO_DeInit(GPIOF, GPIO_PIN_0 | GPIO_PIN_1);

        /* I2C1 interrupt Deinit */
        HAL_NVIC_DisableIRQ(I2C1_IRQn);
    }
}

/* Private functions ---------------------------------------------------------*/
