anttikes/usb-fm-radio/Firmware/Core/dma.h

/**
 ******************************************************************************
 * @file    dma.h
 * @brief   This file contains all the function prototypes for
 *          the dma.c file
 ******************************************************************************
 * @attention
 *
 * Copyright (c) Antti Keskinen
 * All rights reserved.
 *
 * This software is licensed under terms that can be found in the LICENSE file
 * in the root directory of this software component.
 *
 ******************************************************************************
 */

/* Header guard --------------------------------------------------------------*/
#ifndef __DMA_H__
#define __DMA_H__

#ifdef __cplusplus
extern "C"
{
#endif

/* Includes ------------------------------------------------------------------*/
#include "main.h"

/* Exported types ------------------------------------------------------------*/

/* Exported constants --------------------------------------------------------*/

/* Exported macros -----------------------------------------------------------*/

/* Exported functions --------------------------------------------------------*/
extern void MX_DMA_Init(void);

#ifdef __cplusplus
}
#endif

#endif /* __DMA_H__ */
