anttikes/usb-fm-radio/Firmware/Core/gpio.c

/**
 ******************************************************************************
 * @file    gpio.c
 * @brief   This file provides code for the configuration
 *          of all used GPIO pins.
 ******************************************************************************
 * @attention
 *
 * Copyright (c) Antti Keskinen
 * All rights reserved.
 *
 * This software is licensed under terms that can be found in the LICENSE file
 * in the root directory of this software component.
 *
 ******************************************************************************
 */

/* Includes ------------------------------------------------------------------*/
#include "gpio.h"

/* Global variables ----------------------------------------------------------*/

/* Private types -------------------------------------------------------------*/

/* Private constants ---------------------------------------------------------*/

/* Private macros ------------------------------------------------------------*/

/* Private variables ---------------------------------------------------------*/

/* Private function prototypes -----------------------------------------------*/

/* Exported functions --------------------------------------------------------*/

/**
 * @brief  Initialize GPIO
 * @retval None
 */
void MX_GPIO_Init(void)
{
    GPIO_InitTypeDef GPIO_InitStruct = {0};

    /* GPIO Ports Clock Enable */
    __HAL_RCC_GPIOA_CLK_ENABLE();
    __HAL_RCC_GPIOB_CLK_ENABLE();
    __HAL_RCC_GPIOF_CLK_ENABLE();

    /* Configure GPIO pin Output Level */
    HAL_GPIO_WritePin(GPIOA, RD_RST_Pin | OSC_EN_Pin, GPIO_PIN_RESET);

    /* Configure GPIO pin : RD_IRQ_Pin */
    GPIO_InitStruct.Pin = RD_IRQ_Pin;
    GPIO_InitStruct.Mode = GPIO_MODE_IT_FALLING;
    GPIO_InitStruct.Pull = GPIO_NOPULL;
    HAL_GPIO_Init(RD_IRQ_GPIO_Port, &GPIO_InitStruct);

    /* Configure GPIO pins : RD_RST_Pin OSC_EN_Pin */
    GPIO_InitStruct.Pin = RD_RST_Pin | OSC_EN_Pin;
    GPIO_InitStruct.Mode = GPIO_MODE_OUTPUT_PP;
    GPIO_InitStruct.Pull = GPIO_NOPULL;
    GPIO_InitStruct.Speed = GPIO_SPEED_FREQ_LOW;
    HAL_GPIO_Init(GPIOA, &GPIO_InitStruct);

    /* Configure remaining GPIOB pins to analog */
    GPIO_InitStruct.Pin = GPIO_PIN_1 | GPIO_PIN_8;
    GPIO_InitStruct.Mode = GPIO_MODE_ANALOG;
    GPIO_InitStruct.Pull = GPIO_NOPULL;
    HAL_GPIO_Init(GPIOB, &GPIO_InitStruct);

    /* Configure remaining GPIOA pins to analog */
    GPIO_InitStruct.Pin = GPIO_PIN_0 | GPIO_PIN_3;
    GPIO_InitStruct.Mode = GPIO_MODE_ANALOG;
    GPIO_InitStruct.Pull = GPIO_NOPULL;
    HAL_GPIO_Init(GPIOA, &GPIO_InitStruct);

    /* EXTI interrupt init */
    HAL_NVIC_SetPriority(EXTI2_3_IRQn, 0, 0);
    HAL_NVIC_EnableIRQ(EXTI2_3_IRQn);
}

/* External callbacks --------------------------------------------------------*/

/* Private functions ---------------------------------------------------------*/
