anttikes/usb-fm-radio/GUI/src/ReportWorker.cpp

/**
 ******************************************************************************
 * @file    ReportWorker.cpp
 * @brief   Implements the ReportWorker class
 ******************************************************************************
 * @attention
 *
 * Copyright (c) Antti Keskinen
 * All rights reserved.
 *
 * This software is licensed under terms that can be found in the LICENSE file
 * in the root directory of this software component.
 *
 ******************************************************************************
 */

/* Includes ------------------------------------------------------------------*/
#include "ReportWorker.h"
#include <QDebug>
#include <QThread>

/* File-scope Constants & Macros --------------------------------------------*/

/* Anonymous Namespace (File-local helpers and variables) -------------------*/

/* Static Member Definitions ------------------------------------------------*/

/* Constructors & Destructor ------------------------------------------------*/

/**
 * @brief  Constructs the report worker for a selected HID device
 * @param  selectedDevice HID device to read reports from
 *
 * @retval None
 */
ReportWorker::ReportWorker(hid_device *selectedDevice)
    : QRunnable(), m_signalQualityLog("signal_quality_log.csv"), m_selectedDevice(selectedDevice), m_shouldStop(false),
      m_stopped(false)
{
}

/**
 * @brief  Requests that the report worker stop during destruction
 *
 * @retval None
 */
ReportWorker::~ReportWorker()
{
    stop();
}

/* Public Methods -----------------------------------------------------------*/

/**
 * @brief  Requests that the report polling loop stop
 *
 * @retval None
 */
void ReportWorker::stop()
{
    m_shouldStop = true;
}

/**
 * @brief  Polls HID reports, emits parsed reports, and logs signal quality
 *
 * @retval None
 */
void ReportWorker::run()
{
    qDebug() << "[ReportWorker] Report worker is starting up...";

    uint8_t errorCount = 0;
    double frequency = 0.0;

    if (!m_signalQualityLog.open(QIODevice::WriteOnly | QIODevice::Append | QIODevice::Text))
    {
        qDebug() << "[ReportWorker] Failed to open signal quality log file; readings will not be reported";
    }

    while (!m_shouldStop)
    {
        if (errorCount >= 5)
        {
            // If we have errored out, just wait for the loop to end
            QThread::msleep(250);
            continue;
        }

        uint8_t buf[MAX_REPORT_SIZE];

        int res = hid_read_timeout(m_selectedDevice, buf, sizeof(buf), 250);
        if (res > 0)
        {
            errorCount = 0;

            // buf[0] contains the identifier of the report
            ReportIdentifier_t identifier = (ReportIdentifier_t)buf[0];

            switch (identifier)
            {
            case REPORT_IDENTIFIER_DEVICE_STATUS: {
                DeviceStatusResponse_t report;
                std::memcpy(&report, &buf[1], sizeof(DeviceStatusResponse_t));

                double newFrequency = (double)(report.currentFrequency / 100.0);
                if (newFrequency != frequency)
                {
                    if (m_signalQualityLog.isOpen() && frequency > 0.0)
                    {
                        m_signalQualityLog.write("\n");
                    }

                    frequency = newFrequency;
                }

                emit deviceStateReportReceived(report);

                break;
            }
            case REPORT_IDENTIFIER_RSQ_STATUS: {
                RSQStatusResponse_t report;
                std::memcpy(&report, &buf[1], sizeof(RSQStatusResponse_t));

                if (m_signalQualityLog.isOpen() && frequency > 0.0)
                {
                    QString logEntry = QString("%1 MHz\tRSSI: %2 dBuV\tNoise ratio: %3 dB\tStereo pilot detected: "
                                               "%4\tStereo blend: %5 %\tMultipath: %6\n")
                                           .arg(frequency, 0, 'f', 1)
                                           .arg(report.rssi)
                                           .arg(report.snr)
                                           .arg(report.pilot ? "Yes" : "No")
                                           .arg(report.stereoBlend)
                                           .arg(report.multipath);

                    m_signalQualityLog.write(logEntry.toUtf8());
                }

                emit rsqStatusReportReceived(report);

                break;
            }
            case REPORT_IDENTIFIER_RDS_PROGRAMME_SERVICE: {
                RDSProgrammeServiceReport_t report;
                std::memcpy(&report, &buf[1], sizeof(RDSProgrammeServiceReport_t));

                emit rdsProgrammeServiceReportReceived(report);

                break;
            }
            case REPORT_IDENTIFIER_RDS_RADIO_TEXT: {
                RDSRadioTextReport_t report;
                std::memcpy(&report, &buf[1], sizeof(RDSRadioTextReport_t));

                emit rdsRadioTextReportReceived(report);

                break;
            }
            }
        }
        else if (res < 0)
        {
            QString error = QString::fromWCharArray(hid_error(m_selectedDevice));

            qDebug() << "[ReportWorker]: Error during HID read" << error;

            errorCount++;
        }

        if (errorCount >= 5)
        {
            qDebug() << "[ReportWorker]: Too many errors during HID read; signaling DeviceManager.";

            emit errorThresholdExceeded();
        }
    }

    if (m_signalQualityLog.isOpen())
    {
        m_signalQualityLog.close();
    }

    qDebug() << "[ReportWorker] Report worker is shutting down...";

    m_stopped = true;
}

/* Protected Methods --------------------------------------------------------*/

/* Private Methods ----------------------------------------------------------*/

/* External Callbacks / Event Handlers --------------------------------------*/
