anttikes/usb-fm-radio/(commit log)

2025-09-28 Added v0.1 schematic
    [radio-circuit.kicad_pcb, radio-circuit.kicad_sch]
2025-09-28 Added v0.2 schematic, removed deprecation
    [radio-circuit.kicad_pcb, radio-circuit.kicad_sch]
2025-09-28 Added v0.2 bill of materials and position file
    [radio-circuit-bom.csv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]
2025-09-28 Added Device Configuration Tool perspective
2025-09-28 Disabled USBD debug as there's no printf
2025-10-05 Added low-level driver file & settings
2025-10-07 Removed 'Drivers' folder
2025-10-11 Removed STM32 USB library
2025-10-13 Switched to 48 kHz sampling
2025-10-21 Switched to GCC 18, enabled pedantic warnings
2025-10-25 Added timer initialization for status updates
2025-11-08 Fixed USB peripheral clock start location
    [main.c]
2025-11-08 Removed STM32CubeIDE files
2025-11-09 Added necessary bundles for STM32Cube extension
2025-11-09 Removed independent submodules and switched to STM32CubeF0
2025-11-09 Switched to new startup file
2025-11-09 Switched to new linker script
2025-11-09 Moved IoC file to a subdirectory so code generation doesn't break stuff
    [Firmware.ioc]
2025-11-12 Upgraded STM32CubeF0 firmware
2025-11-20 Implemented interrupt-based approach for commands which do not return anything
2025-11-22 Fixed docs, and added prelim support for receiving responses
    [device.c]
2025-11-23 Support for non-command interrupts
2025-11-23 Added timer start for RSQ updates
2025-11-29 Moved timer startup to after tune completes
2025-11-29 Added missing flags to GPIO control
    [common.h]
2025-12-16 Moved STM32 extension settings files to "Firmware"
2025-12-16 Commented out environment printing
2025-12-18 Removed STM32 bundles from GUI
2025-12-22 Added missing CMake and Ninja installation from STM32 extension
2025-12-22 Added missing bits from firmware's STM32 settings
2025-12-22 Removed STM32 bits from GUI
2025-12-26 Tune up & down buttons
2025-12-30 Added power button & stereo indicator
2025-12-30 Fixed moden button's colors
2026-01-06 Added some initial hidapi wirings
2026-01-06 RSQ timer now resets the queue if it gets stuck
    [main.c]
2026-01-10 Removed QML trace from debug output
2026-01-11 Increased the frequency of the RSQ timer
2026-01-11 Timer now stops on power-down, and starts also after seek completes
2026-01-11 Added a task for flashing the current binary into the MCU
2026-01-17 Changed timer to use RSQ status since it is measured each time
2026-01-17 Added support for device listing, selection and showing signal quality
2026-01-17 Added screenshot of the current main window
2026-01-19 Disable controls if no device is selected
2026-01-19 Moved device enumeration to a thread pool worker
2026-01-19 Fixed an issue where device disconnection did not clear the pointer
    [DeviceManager.cpp]
2026-01-23 Switched to gnu2x standard
2026-01-23 Fixed parameter naming in timer init
    [tim.c]
2026-01-23 Moved timer callback to proper location
2026-01-23 Moved report polling to a thread pool worker
2026-01-23 Configure FM de-emphasis to match Europe
2026-02-05 Switched RSQ status to use TIM16, and enabled TIM17 for future use
2026-02-05 Fixed license texts, copyrights and CMake
    [audio_config.h, i2c.c, main.c, tim.c, tim.h]
2026-02-05 Store current frequency and report it to the GUI
2026-02-12 Added tuner dial pin
2026-02-22 Rotated the MCU pins in the STM32CubeMX
2026-02-28 Disabled waiting for the QML debugger to attach
2026-03-02 RSQStatus is now queried whenever device is in power up state
2026-03-02 ReportWorker can now signal DeviceManager to reset the current device if it errors out
    [DeviceManager.cpp, DeviceManager.h, ReportWorker.cpp, ReportWorker.h]
2026-03-09 Added vertical antenna connector library
    [radio-circuit.kicad_sch]
2026-03-09 Added schematic readme, PCB layout and 3D rendering
2026-03-14 Ignore the output folder in Schematic
2026-03-14 Upgraded STM32 tools to latest
2026-03-14 Renamed symbol library
    [radio-circuit.kicad_sch]
2026-03-14 Renamed footprint library
    [radio-circuit.kicad_sch]
2026-03-14 Included 3D model for the coaxial connector
2026-04-10 Added I2C error callback to radio
    [device.c]
2026-04-11 Switched I2C to fast mode
2026-04-11 Upgrade STM32CubeF0 to v1.11.6
2026-04-14 Fixed a broken symbol link in the schematic file
    [radio-circuit.kicad_sch]
2026-04-21 Increased command queue capacity to 20
2026-04-22 Fixed command queue clearing
    [device.c]
2026-04-23 Fix comment formatting in USB-related files
    [audio_config.h, tusb_config.h]
2026-04-25 Added missing abbreviation to seek arguments
    [commands.h]
2026-05-01 Migrated to KiCad v10 format
    [radio-circuit.kicad_pcb, radio-circuit.kicad_sch]
2026-05-01 Updated footprints and symbols to newest versions
    [radio-circuit.kicad_pcb, radio-circuit.kicad_sch]
2026-05-30 Fixed the race condition between interrupts, and the queue no longer overflows
    [device.c, device.h, main.c]
2026-05-31 Added command for obtaining RDS status from the device
2026-06-26 Added support for RDS radio text and programme service (#4)
    * Add librdsparser as submodule
    * Include librdsparser in CMake
    * Initialize RDS parser
    * Stricter cache variables
    * Fixed rebase mishap
    * Fixed compile flag mismatch between firmware and librdsparser
    * Added registration of librdsparser callbacks, and an RDS processing forwarder
    * The device now forwards RDS data to the library
    * The device now reads RDS data when interrupt bits indicate its available
    * Added function to reset RDS parser state
    * Removed unused flag
    * Switch parser subm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
    [DeviceManager.cpp, DeviceManager.h, ReportWorker.cpp, ReportWorker.h, device.c, main.c, rds.c, rds.h]
2026-09-19 Updated STM32MX project to latest tool version
2026-09-28 Completed v0.4 of the design (#5)
    * Added dedicated footprint for the Si4705
    * Took the new footprint into use
    * Switched CubeMX project to use STM32F042F6P6
    * New PCB version with STM32F042F6Px
    * Added a footprint and 3D model for Molex 48037 connector
    * Took connector into use, and started a new PCB layout
    * Switched radio GPIOs to the same side, and updated some labels
    * Finished component placement
    * Updated JLCPCB part numbers
    * Finished traces and layers
    * Removed obsolete bom and position files
    * Fixed via placement for QFN and re-routed STM32 NRST
    * Added 3D model for SG-3030CM
    * Updated BOM and placement details
    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
    [radio-circuit-bom.csv, radio-circuit.kicad_pcb, radio-circuit.kicad_sch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]
2026-09-29 Fixed device identifier in the Firmware project
2026-09-29 Added STM32 build analyzer to recommended extensions, fixed typo from toolchain C flags
2026-10-02 Fixed function naming in GUI
    [DeviceManager.cpp, DeviceManager.h, ReportWorker.cpp, ReportWorker.h]
2026-10-04 Fixed wrong header guards
    [Device.h, DeviceManager.h]
2026-10-04 Device worker's vendor and product ID now come from the outside
2026-10-04 Even if the channel isn't valid, frequency reading is now reported by the device
2026-10-04 Updated STM32CubeF0 to v1.12.0
2026-10-04 Switched back to individual submodules
2026-10-12 Remove the unused RCC CRS global interrupt
2026-10-17 Switched to smaller uint8_t staging buffer
